yomboprime/ZXChat/README.md

# ZXChat
A live chat for ZX Spectrum computers

Revisiones del firmware

r6 Parche para modulos WiFi que no responden OK entre tramas IPD

r5 Parche para evitar que el spectrum pierda el primer byte esporadicamente

r4 Soporta firmware mas reciente del modulo WiFi

r3 Permite usar versiones recientes de Tomcat 8

r2 Permite programar y debuguear en el mismo puerto serie (opcion de intercambiar los puertos serie)

r1 Inicial
