yomboprime/ZXChat/doc/esquema.png

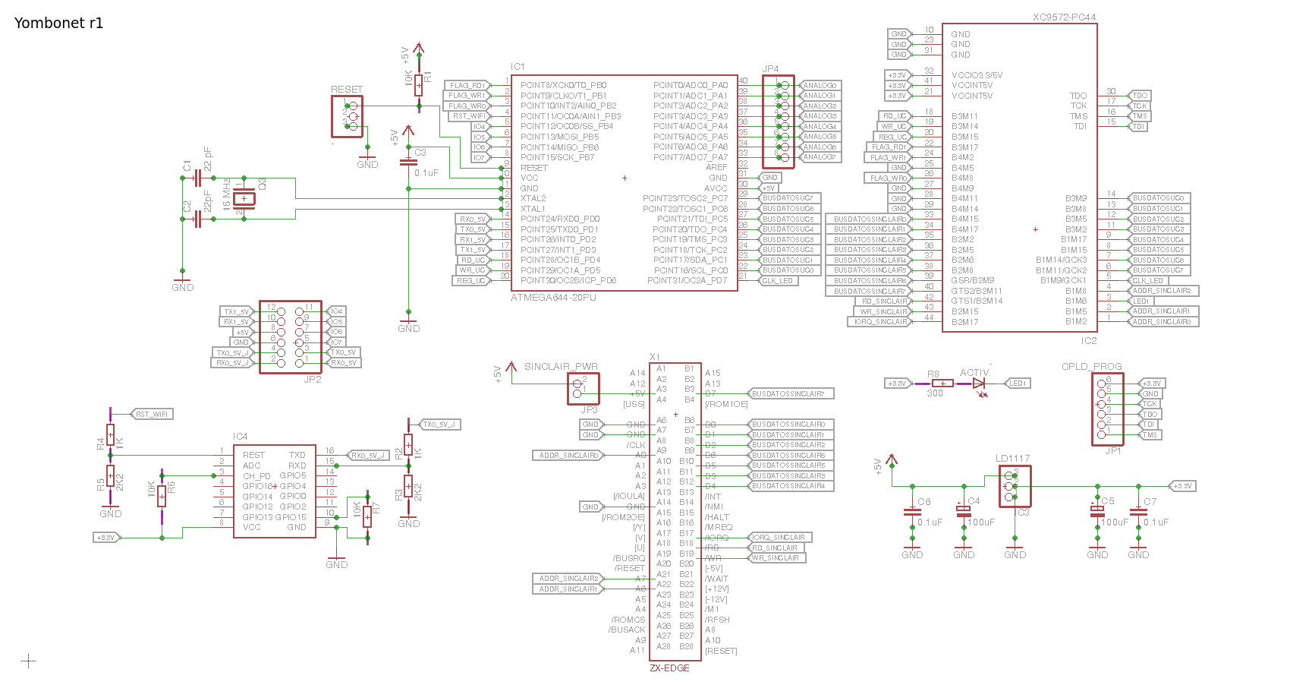
doc/esquema.png
