yomboprime/ZXChat/doc/esquemaCPLD/esquemaCPLD.png

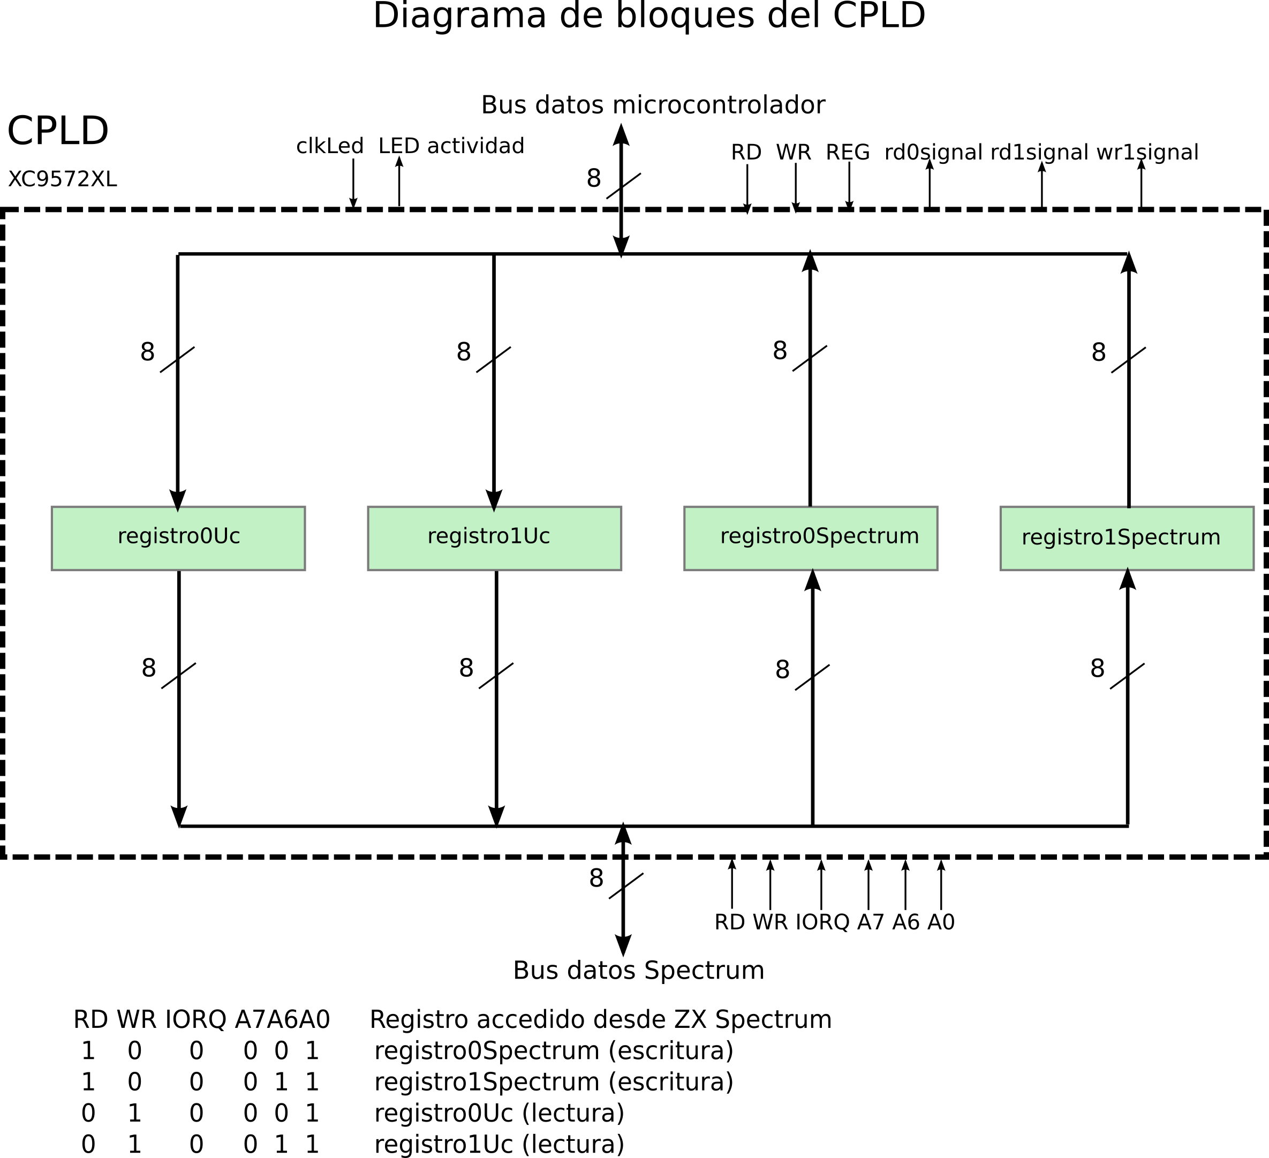
doc/esquemaCPLD/esquemaCPLD.png
