yomboprime/ZXChat/doc/ImagenPlaca2.png

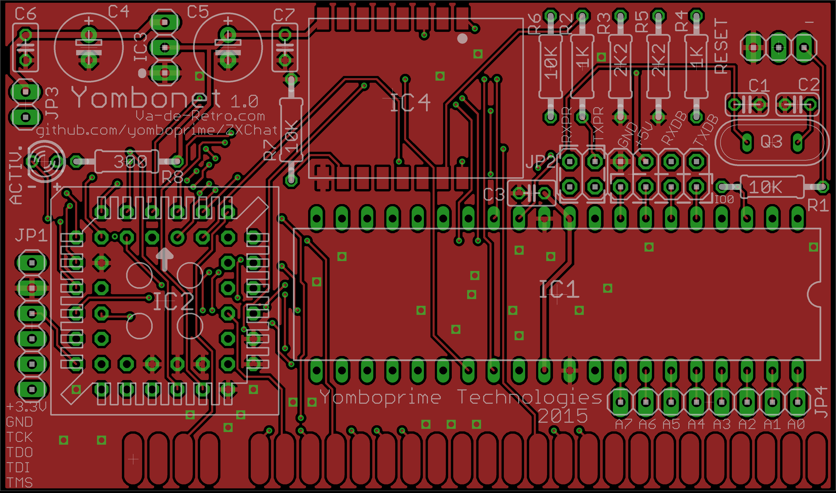
doc/ImagenPlaca2.png
