yomboprime/ZXChat/doc/ImagenPlaca.png

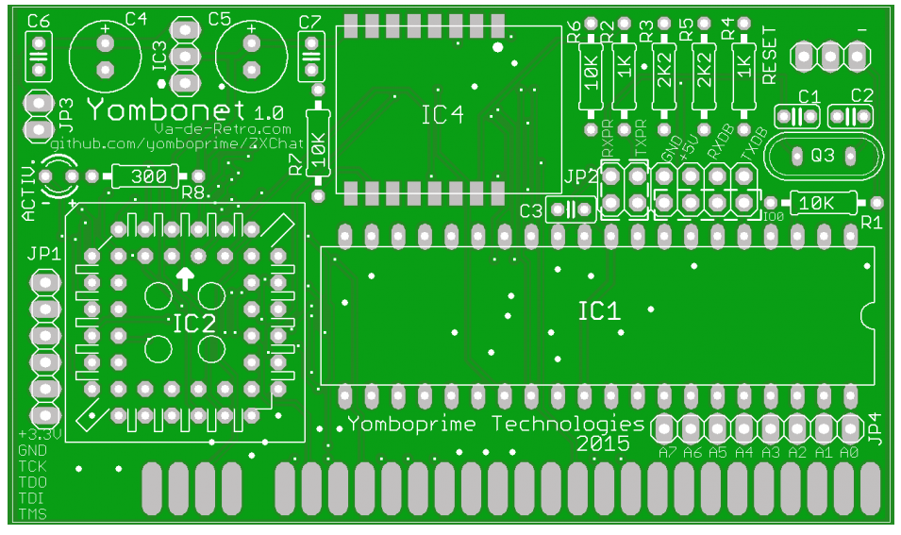
doc/ImagenPlaca.png
