yomboprime/ZXChat/doc/MenuZXChat.png

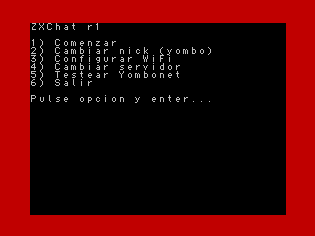
doc/MenuZXChat.png
