yomboprime/ZXChat/doc/BOM Yombonet.ods

Part | Value | Description
ACTIV. | LED 3mm | LED 3mm (green)
C1, C2 | 22 pF | CAPACITOR, 16V
C3, C6, C7 | 0.1uF | CAPACITOR, 16V
C4, C5 | 100uF | POLARIZED CAPACITOR, 16V
IC1 | ATMEGA1284P-PU | Atmel microcontroller
IC2 | XC9572XL-PC44 | Xilinx CPLD
IC3 | LD1117 | LD1117 3V3 regulator
IC4 | ESP-07 | Esp-07 ESP8266 WiFi module
JP1 | CPLD_PROG | PINHD-1X6 male
JP2 |  | PINHD-2X6 male
JP3 | SINCLAIR_PWR | PINHD-1X2 male
JP4 | ANALOG0...7 | PINHD-1X8 female
Q3 | 16 MHz | CRYSTAL
R1, R6, R7 | 10K | RESISTOR, 0.25W
R2, R4 | 1K | RESISTOR, 0.25W
R3, R5 | 2K2 | RESISTOR, 0.25W
R8 | 300 | RESISTOR, 0.25W
RESET | - | Switch
X1 | ZX-EDGE | ZX-Spectrum system bus connector
- | - | PLCC44 socket for the CPLD (44 pins)
- | - | DIP40 socket for the Atmega (40 pins)
