yomboprime/ZXChat/hard/Yombonet/Yombonet.brd

## EAGLE design hard/Yombonet/Yombonet.brd (2015-04-16)

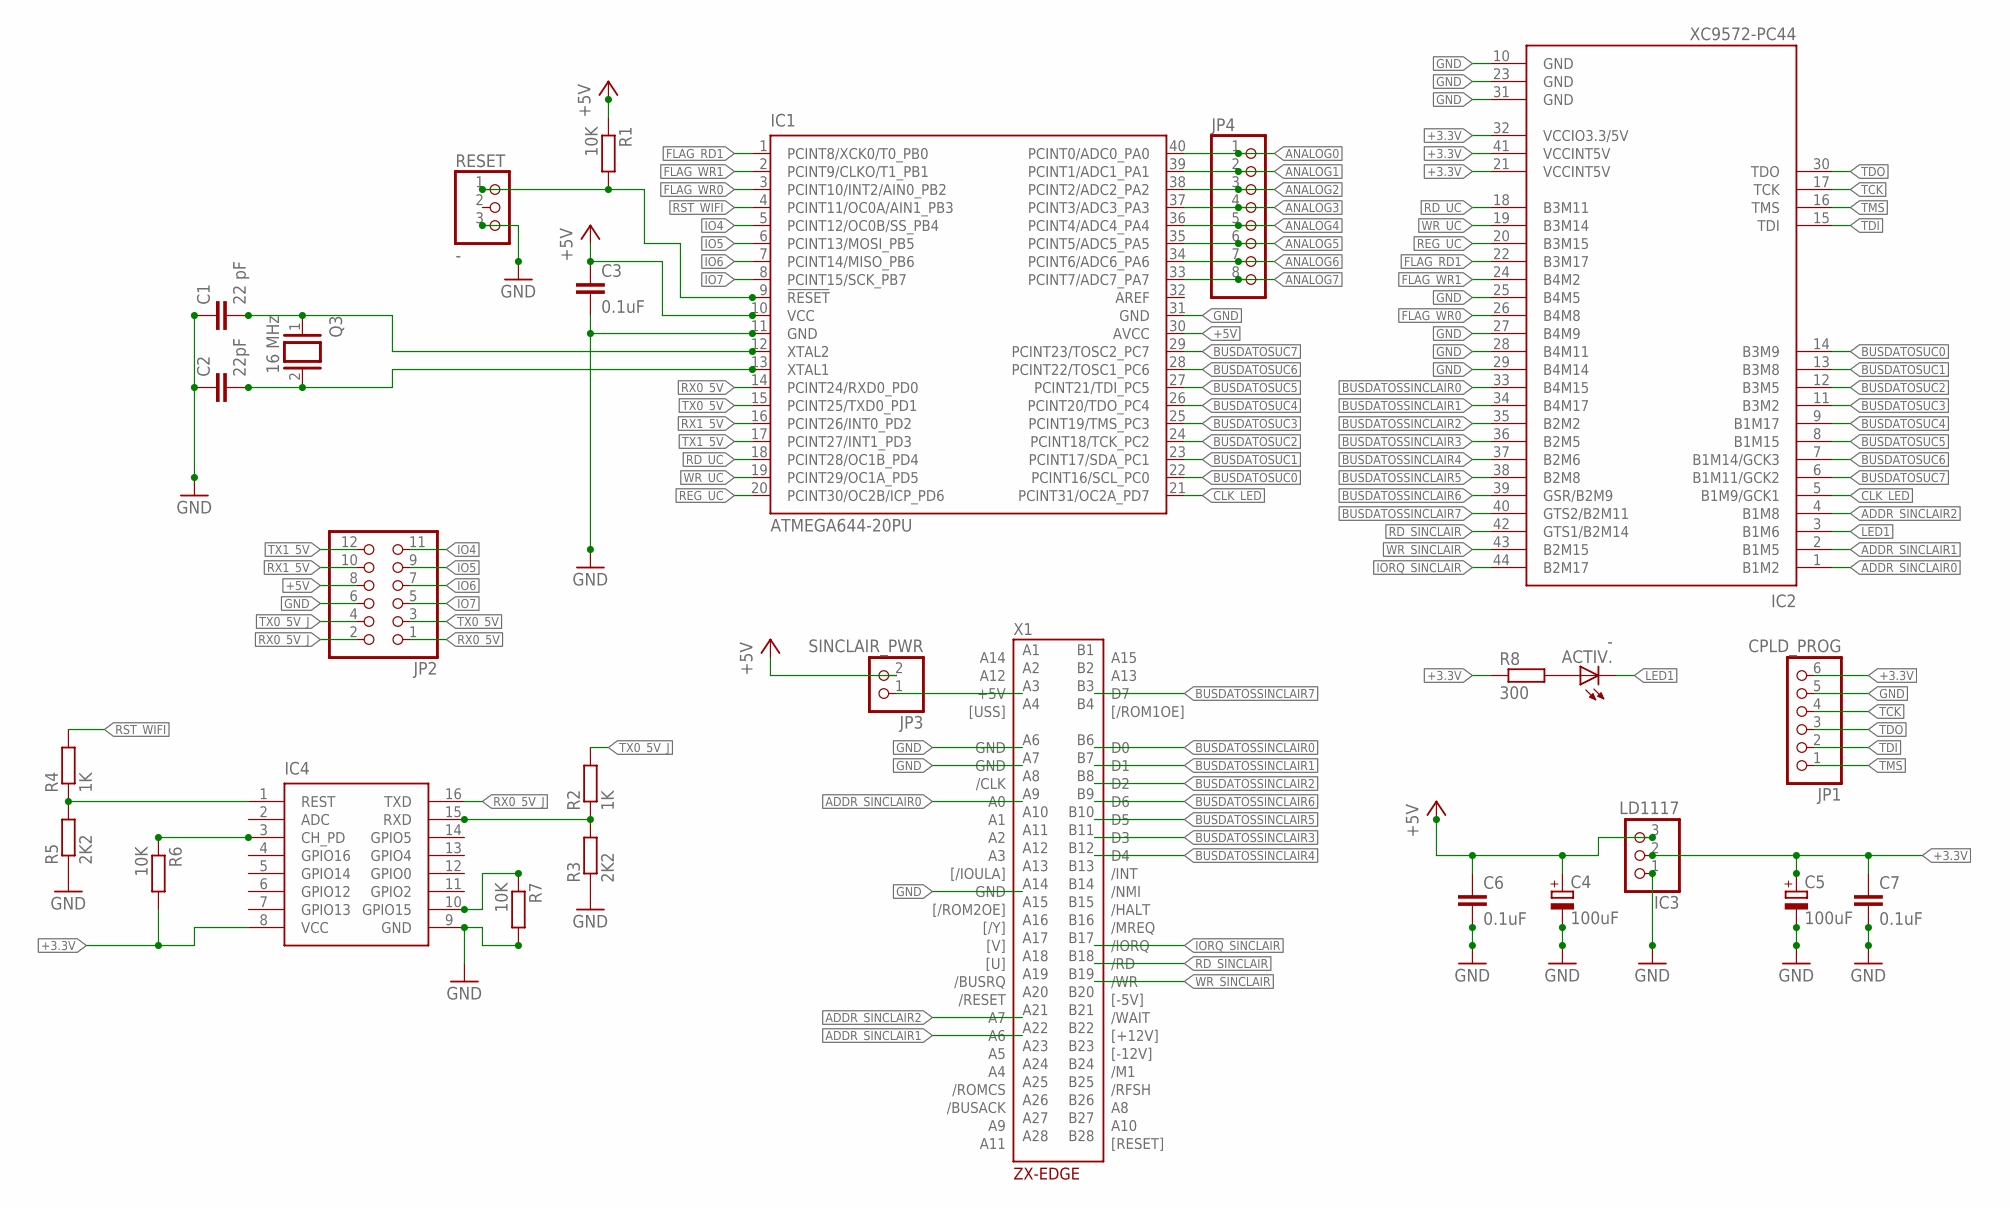
[picture p18: schematic Yombonet.sch]

Parts:
ACTIV.: -; LED3MM
C1: 22 pF; C025-024X044
C2: 22pF; C025-024X044
C3, C6, C7: 0.1uF; C025-025X050
C4, C5: 100uF; E2,5-7
IC1: ATMEGA644-20PU; DIL40
IC2: XC9572-PC44; PLCC-S44
IC3: LD1117; 1X03
IC4: ESP-07ESP-07; ESP-07
JP1: CPLD_PROG; 1X06
JP2: PINHD-2X6; 2X06
JP3: SINCLAIR_PWR; 1X02
JP4: PINHD-1X8; 1X08
Q3: 16 MHz; QS
R1, R6, R7: 10K; 0207/10
R2, R4: 1K; 0207/10
R3, R5: 2K2; 0207/10
R8: 300; 0207/10
RESET: -; 1X03
X1: ZX-EDGE; ZX-IFACE

Connections:
+3.3V: C5.+, C7.1, IC2.21 (VCCINT5V), IC2.32 (VCCIO3.3/5V), IC2.41 (VCCINT5V), IC3.2, IC4.8 (VCC), JP1.6, R6.2, R8.1
+5V: C3.1, C4.+, C6.1, IC1.10 (VCC), IC1.30 (AVCC), IC3.3, JP2.8, JP3.2, R1.1
ADDR_SINCLAIR0: IC2.1 (B1M2), X1.A9 (A0)
ADDR_SINCLAIR1: IC2.2 (B1M5), X1.A22 (A6)
ADDR_SINCLAIR2: IC2.4 (B1M8), X1.A21 (A7)
ANALOG0: IC1.40 (PCINT0/ADC0_PA0), JP4.1
ANALOG1: IC1.39 (PCINT1/ADC1_PA1), JP4.2
ANALOG2: IC1.38 (PCINT2/ADC2_PA2), JP4.3
ANALOG3: IC1.37 (PCINT3/ADC3_PA3), JP4.4
ANALOG4: IC1.36 (PCINT4/ADC4_PA4), JP4.5
ANALOG5: IC1.35 (PCINT5/ADC5_PA5), JP4.6
ANALOG6: IC1.34 (PCINT6/ADC6_PA6), JP4.7
ANALOG7: IC1.33 (PCINT7/ADC7_PA7), JP4.8
BUSDATOSSINCLAIR0: IC2.33 (B4M15), X1.B6 (D0)
BUSDATOSSINCLAIR1: IC2.34 (B4M17), X1.B7 (D1)
BUSDATOSSINCLAIR2: IC2.35 (B2M2), X1.B8 (D2)
BUSDATOSSINCLAIR3: IC2.36 (B2M5), X1.B11 (D3)
BUSDATOSSINCLAIR4: IC2.37 (B2M6), X1.B12 (D4)
BUSDATOSSINCLAIR5: IC2.38 (B2M8), X1.B10 (D5)
BUSDATOSSINCLAIR6: IC2.39 (GSR/B2M9), X1.B9 (D6)
BUSDATOSSINCLAIR7: IC2.40 (GTS2/B2M11), X1.B3 (D7)
BUSDATOSUC0: IC1.22 (PCINT16/SCL_PC0), IC2.14 (B3M9)
BUSDATOSUC1: IC1.23 (PCINT17/SDA_PC1), IC2.13 (B3M8)
BUSDATOSUC2: IC1.24 (PCINT18/TCK_PC2), IC2.12 (B3M5)
BUSDATOSUC3: IC1.25 (PCINT19/TMS_PC3), IC2.11 (B3M2)
BUSDATOSUC4: IC1.26 (PCINT20/TDO_PC4), IC2.9 (B1M17)
BUSDATOSUC5: IC1.27 (PCINT21/TDI_PC5), IC2.8 (B1M15)
BUSDATOSUC6: IC1.28 (PCINT22/TOSC1_PC6), IC2.7 (B1M14/GCK3)
BUSDATOSUC7: IC1.29 (PCINT23/TOSC2_PC7), IC2.6 (B1M11/GCK2)
CH_PH_PULLUP: IC4.3 (CH_PD), R6.1
CLK_LED: IC1.21 (PCINT31/OC2A_PD7), IC2.5 (B1M9/GCK1)
FLAG_RD1: IC1.1 (PCINT8/XCK0/T0_PB0), IC2.22 (B3M17)
FLAG_WR0: IC1.3 (PCINT10/INT2/AIN0_PB2), IC2.26 (B4M8)
FLAG_WR1: IC1.2 (PCINT9/CLKO/T1_PB1), IC2.24 (B4M2)
GND: C1.1, C2.1, C3.2, C4.-, C5.-, C6.2, C7.2, IC1.11 (GND), IC1.31 (GND), IC2.10 (GND), IC2.23 (GND), IC2.25 (B4M5), IC2.27 (B4M9), IC2.28 (B4M11), IC2.29 (B4M14), IC2.31 (GND), IC3.1, IC4.9 (GND), JP1.5, JP2.6, R3.1, R5.1, R7.2, RESET.3, X1.A6 (GND), X1.A7 (GND), X1.A14 (GND)
GPIO15_PULLDOWN: IC4.10 (GPIO15), R7.1
IO4: IC1.5 (PCINT12/OC0B/SS_PB4), JP2.11
IO5: IC1.6 (PCINT13/MOSI_PB5), JP2.9
IO6: IC1.7 (PCINT14/MISO_PB6), JP2.7
IO7: IC1.8 (PCINT15/SCK_PB7), JP2.5
IORQ_SINCLAIR: IC2.44 (B2M17), X1.B17 (/IORQ)
LED1: ACTIV..K (C), IC2.3 (B1M6)
unnamed: IC4.15 (RXD), R2.1, R3.2
unnamed: ACTIV..A, R8.2
unnamed: JP3.1, X1.A3 (+5V)
OSC1: C1.2, IC1.12 (XTAL2), Q3.1
OSC2: C2.2, IC1.13 (XTAL1), Q3.2
RD_SINCLAIR: IC2.42 (GTS1/B2M14), X1.B18 (/RD)
RD_UC: IC1.18 (PCINT28/OC1B_PD4), IC2.18 (B3M11)
REG_UC: IC1.20 (PCINT30/OC2B/ICP_PD6), IC2.20 (B3M15)
RESET_UC: IC1.9 (!RESET), R1.2, RESET.1
RST_WIFI: IC1.4 (PCINT11/OC0A/AIN1_PB3), R4.2
RST_WIFI_3.3V: IC4.1 (REST), R4.1, R5.2
RX0_5V: IC1.14 (PCINT24/RXD0_PD0), JP2.1
RX0_5V_J: IC4.16 (TXD), JP2.2
RX1_5V: IC1.16 (PCINT26/INT0_PD2), JP2.10
TCK: IC2.17 (TCK), JP1.4
TDI: IC2.15 (TDI), JP1.2
TDO: IC2.30 (TDO), JP1.3
TMS: IC2.16 (TMS), JP1.1
TX0_5V: IC1.15 (PCINT25/TXD0_PD1), JP2.3
TX0_5V_J: JP2.4, R2.2
TX1_5V: IC1.17 (PCINT27/INT1_PD3), JP2.12
WR_SINCLAIR: IC2.43 (B2M15), X1.B19 (/WR)
WR_UC: IC1.19 (PCINT29/OC1A_PD5), IC2.19 (B3M14)

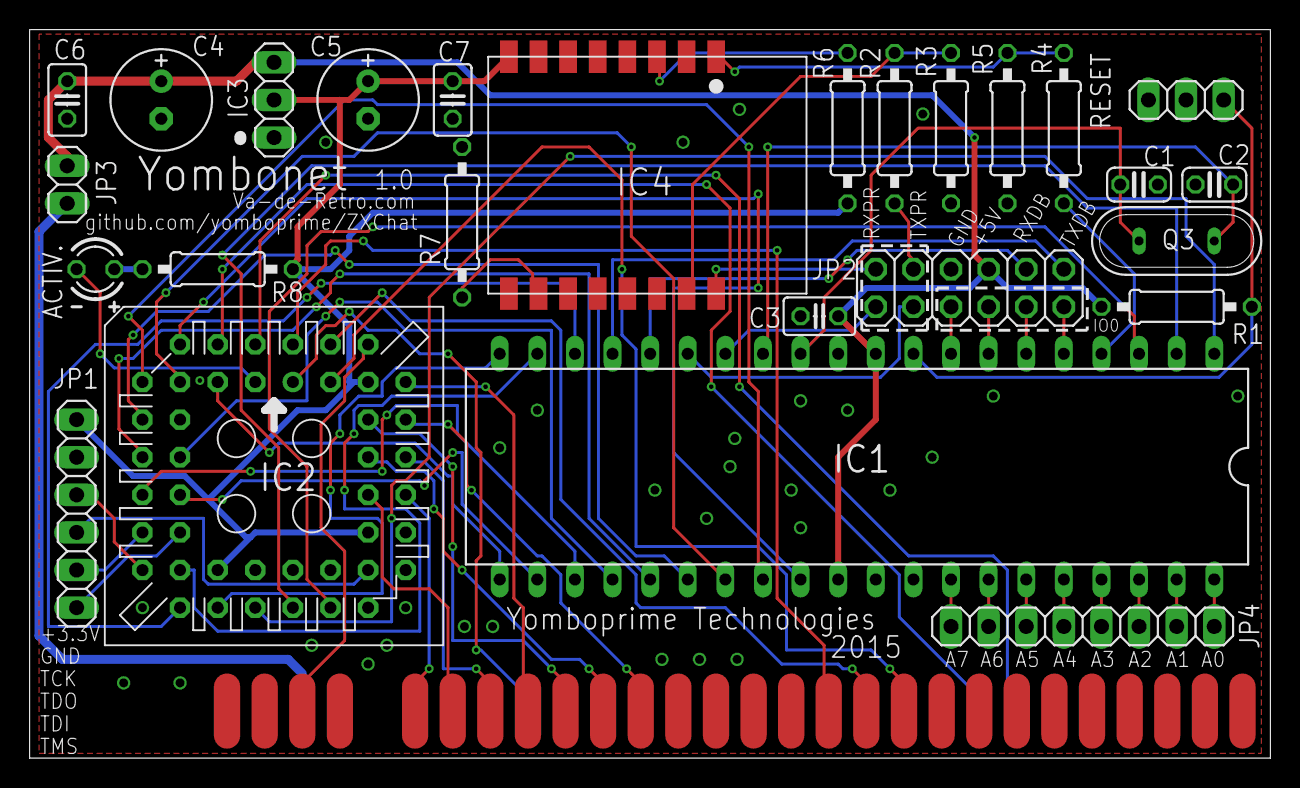
[picture p19: board Yombonet.brd from above]

Board: 4 copper layers, 83.8 x 49.2 mm, 27 parts (0 on the bottom side), 65 nets.
