yomboprime/ZXChat/(commit log)

2015-03-19 Commit inicial
    [InterfazRobotSpectrum_pad.csv, InterfazSpectrum.sch]
2015-03-19 Esquema: añadido conector de programacion de cpld. Prueba de posicionado.
    [esquema.sch]
2015-03-20 Añadido conector Edge y conector del LD1117 vertical
    [esquema.sch]
2015-03-20 Faltaba el fichero de la PCB de eagle
    [esquema.brd, esquema.sch]
2015-03-21 Esquema: Añadido módulo wifi y conectores I/O
    [esquema.brd, esquema.sch]
2015-03-21 Arregladas algunas señales que no estaban conectadas en el cpld, módulo wifi y conector edge.
    [esquema.brd, esquema.sch]
2015-03-21 Modificada resistencia R8, el valor correcto es 300 Ohm
    [esquema.brd, esquema.sch]
2015-03-24 Subiendo presupuesto
    [Materiales.ods]
2015-03-24 Actualizado envio de materiales farnell
    [Materiales.ods]
2015-03-25 CPLD software: Cambiado el CPLD a la version de 3.3V (XC9572XL)
    [InterfazRobotSpectrum_pad.csv]
2015-03-25 Version preliminar de la PCB (PR3)
    [Yombonet.brd, Yombonet.sch, esquema.brd]
2015-03-25 Actualizado presupuesto, cambios menores (no hay cambios en precios)
    [Materiales.ods]
2015-03-25 Subiendo gerbers preliminares (PR3)
    [ZXChat.gbl, ZXChat.gbo, ZXChat.gbs, ZXChat.gtl, ZXChat.gto, ZXChat.gts]
2015-03-28 Codigo CPLD: Cambiado A0A7A6 por A7A6A0, el patillaje de estas lineas ya no es igual que en el prototipo.
    [InterfazRobotSpectrum_pad.csv]
2015-03-28 PCB: Anyadidas dos vias de masa
    [Yombonet.brd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]
2015-03-29 PCB: Cambiado nick de acf76es por retrocant
    [Yombonet.brd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]
2015-03-29 Subiendo presupuesto ebay-aliexpress
    [Materiales_ebay_aliexpress.ods]
2015-04-02 Esquematico: Cambiados varios conectores a uno solo de 2x6
    [Yombonet.brd, Yombonet.sch]
2015-04-04 PCB: Cambios en pistas, serigrafia y posicion vias
    [Yombonet.brd]
2015-04-10 Presupuesto: Actualizado link al zocalo PLCC44, que era SMD erroneamente. Ahora es through hole.
    [Materiales_ebay_aliexpress.ods]
2015-04-10 PCB: Anadidas mas vias de plano de masa
    [Yombonet.brd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]
2015-04-10 PCB: Actualizado silkscreen con nick de vidamia
    [Yombonet.brd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]
2015-04-10 Presupuesto: Actualizado link del Atmega32A
    [Materiales_ebay_aliexpress.ods]
2015-04-10 Subiendo fichero de materiales, Bill Of Materials (BOM)
    [BOM Yombonet.ods]
2015-04-11 BOM: Componentes agrupados por valor.
    [BOM Yombonet.ods]
2015-04-13 Actualizadas compras
    [Materiales_ebay_aliexpress.ods]
2015-04-15 Doc: Actualizado estado compra. Borrado fichero materiales farnell
    [Materiales.ods, Materiales_ebay_aliexpress.ods]
2015-04-16 PCB: modificada una pista y anyadidas 3 vias. Version subida a Seeedstudio.
    [Yombonet.brd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]
2015-04-16 PCB: Movidos nicks a silkscreen de abajo. Ahora si, enviada a Seeed, r1
    [Yombonet.brd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]
2015-04-18 ZXChat: Cambios menores, prueba de envio de codigo de error al spectrum
    [ModuloWiFi.cpp]
2015-04-21 Subido soporte arduino para mighty-1284p y Atmega32A
    [pins.ods]
2015-04-21 Actualizada lista de compras
    [Materiales_ebay_aliexpress.ods]
2015-04-21 Empezadas instrucciones con el formato final
2015-04-29 Instrucciones implementadas: Obtener numero de revision, activar/desactivar debug, y conectar a wifi.
2015-05-08 Actualizado fichero compras con ultimos componentes llegados
    [Materiales_ebay_aliexpress.ods]
2015-05-08 Empezado el menu de ZXChat
2015-05-10 Mejoras docs
    [BOM Yombonet.ods]
2015-05-10 Implementadas todas las opciones de menu. Ya accede a YomboServer. Programa ZXChat practicamente terminado.
2015-05-19 Subiendo YomboServer actualizado con ultimos cambios (control de tamaño de mensajes enviados)
2015-06-02 ZXuiter (tramas HTTP POST anyadidas). Ejemplos nuevos.
    [Materiales_ebay_aliexpress.ods]
2015-07-18 Yombonet 1.0 funcionando con el microcontrolador Atmega1284P en vez del Atmega32A
2015-07-30 Corregido bug de limitar el tamanyo de la salida.
    [Yombonet.ino]
2015-10-19 Arreglado fallo de sintaxis en r2
    [ModuloWiFi.cpp]
2015-10-20 Arreglada velocidad baudios, estaba fija
    [ModuloWiFi.cpp, Yombonet.ino]
2015-10-20 Corrigiendo define olvidado. Firmware r4
    [Yombonet.ino]
2015-10-21 Bug valores boleanos. Salida de los primeros 10 bytes para error esporadico.
    [ModuloWiFi.cpp, Yombonet.ino]
2015-10-23 Quitando debug de timestamp, poniendolo en sketch YombonetPruebaFermars
2015-10-24 Restaurando sketch Yombonet para ver si se arregla error de conexion.
    [ModuloWiFi.cpp]
2015-10-25 Parcheando programa y server para que el spectrum anyada un espacio al timestamp.
2015-10-26 Parche para evitar perdida de primer caracter, arreglado.
    [ModuloWiFi.cpp, ModuloWiFi.h, Yombonet.ino]
2015-10-31 Actualizando BOM
    [BOM Yombonet.ods]
2015-10-31 Parche para modulos WiFi que no responden OK entre tramas IPD
2015-11-01 r6, r3. Solucionado bug de pulsar reset al inicio. Ahora no se imprimen codigos de error.
    [Yombonet.ino]
2015-11-02 Accion historial en el server.
2015-11-04 Volviendo a comentar lectura registro control para evitar boton reset
    [Yombonet.ino]
2015-11-05 Faltaban los zócalos en el Bill Of Materials
    [BOM Yombonet.ods]
